Bastardkb/charybdis-pmw-3360-sensor-pcb/pics/1.jpg

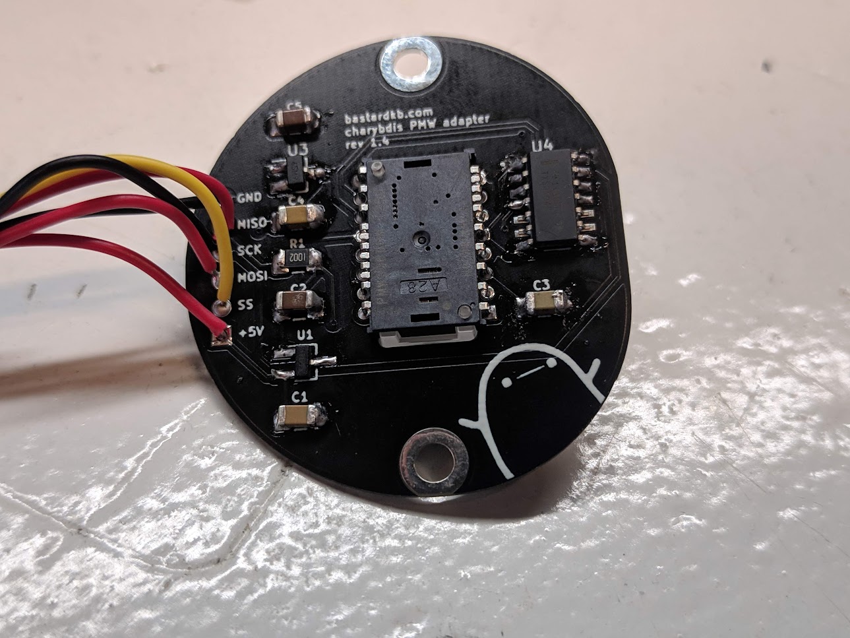
pics/1.jpg
