Bastardkb/charybdis-pmw-3360-sensor-pcb/(threads)

Thread 2 (2022-08-30):

PCB in release section uses wrong/non-existing parts

Nobodi99, 2022-08-30:
I am in the process of ordering the sensor pcb with the files provided in the release section.
There are some problems with the parts used and the files provided .

1) The parts used are metric 0603 but jlcpcb uses imperial code in their systems. That means the parts don't fit and trying to find replacements is not possible because there are no 0603/0201 10uF capacitors. And the other parts are non standard which makes them way more expensive because of the extra charge.

2) The cpl file places the parts outside the pcb and the orientation is wrong on some parts.

That means that those files are basically useless and need to be fixed in my opinion.

bstiq, 2022-08-31:
Hello,

1/ I've had no issue ordering the PCBs on JLC, and had multiple reports of it working well for others. So the 0603 parts will work fine.
I used whichever parts I found best, standard or not. The PCBs still come out at around 4-5 eur per unit if you order 10 of them or so iirc.

2/ This happens frequently with JLC, they will correct it. Just make sure the orientation is correct on the parts - they tend to place the level shifter rotated wrong.

I'm sorry you find the files useless, feel free to push a PR with the fixes you proposed !
Meanwhile, I will close this issue.

Regards,

Nobodi99, 2022-08-31:
Thanks for fixing the file.
Before your new upload it was 1.6pre1.zip and that had the smaller parts and was therefore not usable.
The 1.6e.zip has bigger pads and is correct for the 0603 parts size.
Would have been nice of you to at least say that you fixed it instead of just saying it worked for you...

bstiq, 2022-08-31:
Hey,

The other files were in testing, which I confirmed working. Just forgot to update the release.
This is also a kind reminder that this is an open source project that is provided as is, and I have no obligation to it or you.
Acting entitled just makes you look bad.

Regards,

Closed 2022-08-31.

Thread 3 (2023-02-05):

Question about TXS0104EDR

superjax, 2023-02-05:
Hey!  Thank you for putting this online.  I really appreciate the work here.

It looks like the `master` version of the code is using a different footprint part for the voltage-level translator than what's
called out in the README (and also the kicad files, I'm not mistaken).

What part are you using there, or can you point me to the `TXS0104EDR` that has the right footprint?

bstiq, 2023-02-06:
Hello,

The latest release and master branch now use PCB assembly only.
If you are going to DIY, use the BOM from the readme and the gerber files from release 1.51.
If you are going to PCBA, use the gerber and BOM, POS files from the latest release (1.7).

I will close this now, but feel free to reopen if there's anything else.

Closed 2023-02-06.

Thread 8 (2023-03-31):

AP7331-20WG-7

GeekAnnoyed, 2023-03-31:
Hello
sorry I'm still a noob with electronics

I'm thinking of using this as a sensor for my keyboard trackball
but I'm having issues getting the AP7331-20WG-7 without incurring a crazy shipping fee (over £9 for a sub £2 order)
is the an alternate regulator I could use?

many thanks

bstiq, 2023-04-01:
Hello,

That is usually the issue when ordering the components separately yes.
I order those factory-assembled now, so can't recommend any other shop source.

You could also get an ap7331-wg-7, but then make sure to install R2 and R3 as you'll need those to indicate the required output voltage.

Finally, another option is to just look for 2V voltage regulators. You can use different website's search engines for that (mouser, farnell, radiospare all have voltage regulator sections)

When choosing, pay attention to:
- the format of the component
- the pinout which needs to be the same
- the current output - if the regulator can't supply enough current the sensor will not work
Regarding the last issue, I had exactly this problem and it induced a bad coil whine (although with another regulator). I talk about it here: https://www.youtube.com/watch?v=xcH720h-YqM

The part number mentioned in the BOM is the only one I tested, so I can't vouch / guarantee for any other ones.

If you are a newcomer with electronics and also with soldering, then I recommend paying a bit extra and ordering the assembled version from eg. JLCPCB. Soldering the components of the DIY version is difficult and you *will* encounter issues where the sensor doesn't work and it's impossible to figure out why (speaking from experience).

I hope this helps !

Regards,

GeekAnnoyed, 2023-04-02:
*hides face in geek shame*

I honestly didn't look at JLCPCB as during my last project with a different PCB manufacturer I almost choked on my coffee when I got a quote for the component assembly too.

I'm not too bad at soldering, not awesome but bad it's the design part I fail with.

But thank you for the JLCPCB advice.

I will close this when I get home again

Regards
Richard

1 Apr 2023 5:09:23 pm Quentin 'notifications at github.com' ***@***.***>:

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

Thread 9 (2023-05-28):

PMW3360DM-T2QU not avaliable

Kulllerkeks, 2023-05-28:
Hey!

At first thanks for the work! Im currently wrapping my head around building a Charybdis nano.

I was clicking trough a jlcpcb order to get the senor manufactured and assembled but it seems  PMW3360DM-T2QU is not available?

 I cant find the part even in the parts management of jlcpcb.

Is this a recent change? Or should i order from a different service?

thanks in advance! love your work.

Kulllerkeks, 2023-05-28:
i may be dump.
i need to source the part myself am i right?

bstiq, 2023-05-28:
Yes, and handsolder it (it's pretty easy).
Make sure to get the exact reference (PMW3360), other versions have different pinout and won't work (eg. 3610).

Kulllerkeks, 2023-05-28:
tanks a lot!

Closed 2023-05-28.

Thread 10 (2023-12-03):

Flip emergency 6pin header

bstiq, 2023-12-03:
Needs to be on the other side of the PCB

bstiq, 2024-01-16:
no space for this, will keep as is

Thread 11 (2024-01-11):

Missing M3 holes

bstiq, 2024-01-11:

Closed 2024-01-16.

Thread 13 (2025-08-27):

Missing components in position.csv file. 2.0 Release.

jtcaraball, 2025-08-27:
Hi! Two components, `J1001` and `U1001`, which are declared in bom.csv seem to be missing from position.csv. I was wondering if this was intentional?

Thank you so much for all your hard work!
(Loving my skeletyl :heart:).

bstiq, 2025-08-28:
Hello,

Thanks for the notice. I removed the components from the BOM.

Closed 2025-08-28.
