Bastardkb/charybdis-pmw-3360-sensor-pcb/(commit log)

2021-07-07 libraries and schematic
    [sensor.kicad_pcb, sensor.kicad_sch]
2021-07-07 add PWR labels
    [sensor.kicad_sch]
2021-07-07 clean up pcb
    [sensor.kicad_pcb]
2021-07-07 remove uneeded footprints
    [sensor.kicad_pcb, sensor.kicad_sch]
2021-07-07 add sensor footprint
2021-07-07 assign footprints
    [sensor.kicad_pcb, sensor.kicad_sch]
2021-07-08 edge cuts
    [sensor.kicad_pcb]
2021-07-08 fix bom
    [sensor.kicad_pcb, sensor.kicad_sch]
2021-07-08 ignore gerbers
2021-07-09 change LDO
    [sensor.kicad_pcb, sensor.kicad_sch]
2021-07-09 increment version to 1.3
    [sensor.kicad_pcb]
2021-07-09 bigger pads for level shifter
    [sensor.kicad_pcb, sensor.kicad_sch]
2021-07-09 add BOM
2021-07-22 switch level shifter to TXS0104EDR
    [sensor.kicad_sch]
2021-08-04 add schematic
2021-09-03 add new ldo
    [sensor.kicad_pcb, sensor.kicad_sch]
2021-09-03 add resistor on led p
    [sensor.kicad_pcb, sensor.kicad_sch]
2021-09-03 add xc6206 for smt assembly
    [sensor.kicad_pcb, sensor.kicad_sch]
2021-09-12 update lcsc part numbers
    [sensor.kicad_sch]
2021-09-14 remove old LDOw
    [sensor.kicad_pcb, sensor.kicad_sch]
2021-09-14 update bom
2021-09-14 update schem
    [sensor.kicad_sch]
2021-10-06 change ldo and resistor
    [sensor.kicad_pcb, sensor.kicad_sch]
2021-11-30 add back indication for lens
    [sensor.kicad_pcb]
2022-04-22 switch to qfn14
    [sensor.kicad_pcb, sensor.kicad_sch]
2022-04-24 switch to 0603
    [sensor.kicad_pcb, sensor.kicad_sch]
2022-04-24 switch 3.3v ldo to assembly footprint rather than handsoldering
    [sensor.kicad_pcb, sensor.kicad_sch]
2022-04-24 connect level shifter thermal pad to gnd
    [sensor.kicad_pcb]
2022-05-03 0603 components
    [sensor.kicad_pcb, sensor.kicad_sch]
2022-05-03 standard footprint for ic1
    [sensor.kicad_pcb]
2022-09-13 make sensor round again
    [sensor.kicad_pcb, sensor.kicad_sch]
2023-03-17 remove unconnected pins
    [sensor.kicad_pcb]
2023-05-25 bigger sensor pins
    [sensor.kicad_pcb]
2023-05-25 version number
    [sensor.kicad_pcb]
2023-10-04 tht solder only on one side
    [sensor.kicad_pcb, sensor.kicad_sch]
2023-10-08 add JST
    [sensor.kicad_pcb, sensor.kicad_sch]
2023-11-02 routing, DRC
    [sensor.kicad_pcb]
2023-11-21 component placement
    [sensor.kicad_pcb]
2023-11-21 silkscreen detrompeur
    [sensor.kicad_pcb, sensor.kicad_sch]
2024-01-16 add back m3 holes :(
    [sensor.kicad_pcb, sensor.kicad_sch]
2024-12-06 connect vik
    [sensor.kicad_pcb, sensor.kicad_sch]
2024-12-06 remove 3v3 ldo and level shifter
    [sensor.kicad_pcb, sensor.kicad_sch]
2024-12-06 connect motion pin
    [sensor.kicad_pcb]
