Bastardkb/charybdis-pmw-3360-sensor-pcb/(notices)

Notices in the files:
sensor/sensor.kicad_sch:
Copyright Quentin Lebastard
